KoljaWindeler/CHIP_QUESO/schematics/v4_adapter_ordered/single.png

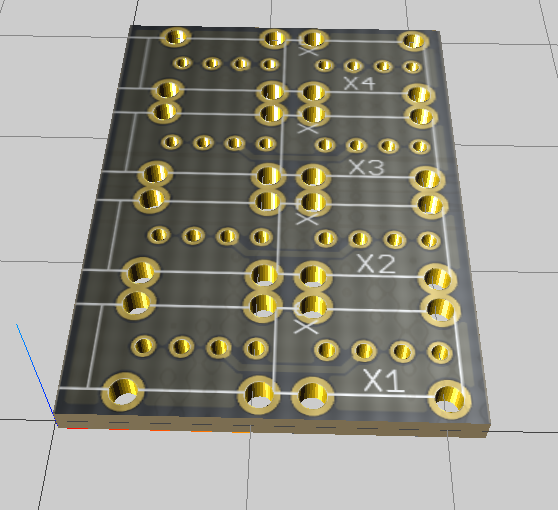
schematics/v4_adapter_ordered/single.png
