KoljaWindeler/CHIP_QUESO/docs/DSC_0504.JPG

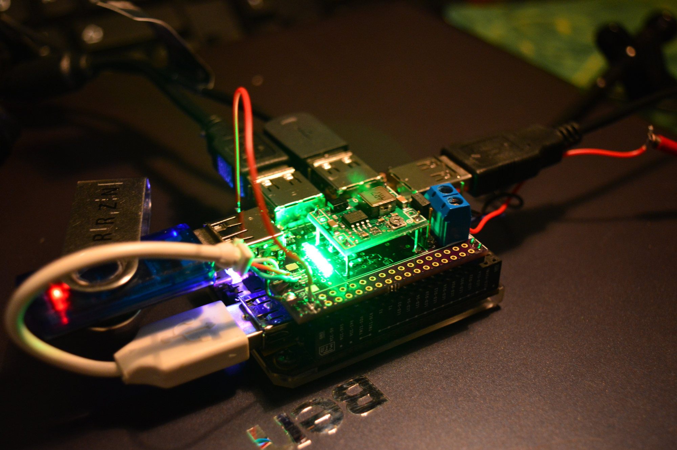
docs/DSC_0504.JPG
