KoljaWindeler/CHIP_QUESO/README

please read http://koljawindeler.github.io/CHIP_QUESO
