KoljaWindeler/CHIP_QUESO/docs/Dip_250x338.bmp

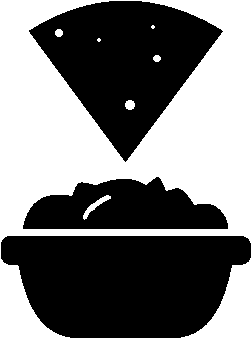
docs/Dip_250x338.bmp
