KoljaWindeler/CHIP_QUESO/docs/DSC_0506.JPG

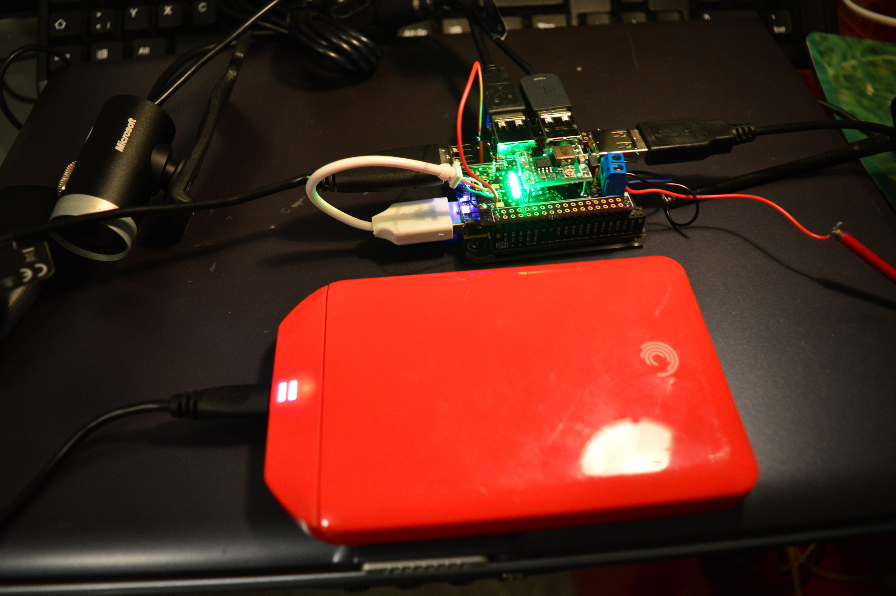
docs/DSC_0506.JPG
