KoljaWindeler/CHIP_QUESO/schematics/v45_ordered/queso_dip_v4_5.pdf

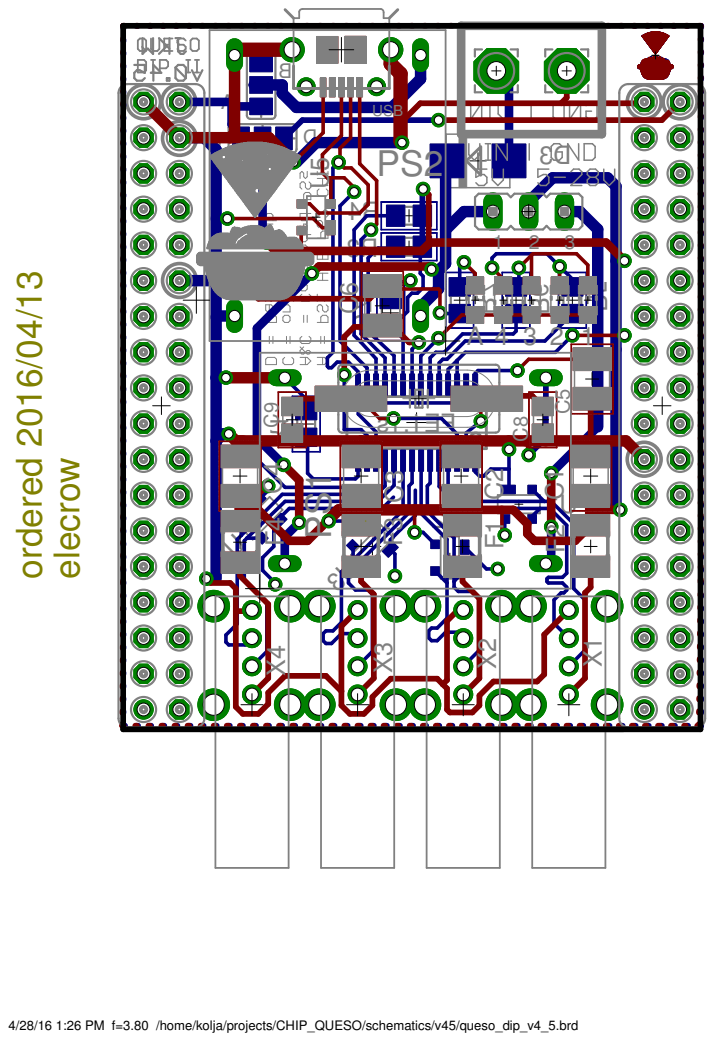
[picture p6: page 1]

4/28/16 1:26 PM f=3.80 /home/kolja/projects/CHIP_QUESO/schematics/v45/queso_dip_v4_5.brd
