KoljaWindeler/CHIP_QUESO/schematics/v45_ordered/queso_dip_v4_5_sch.pdf

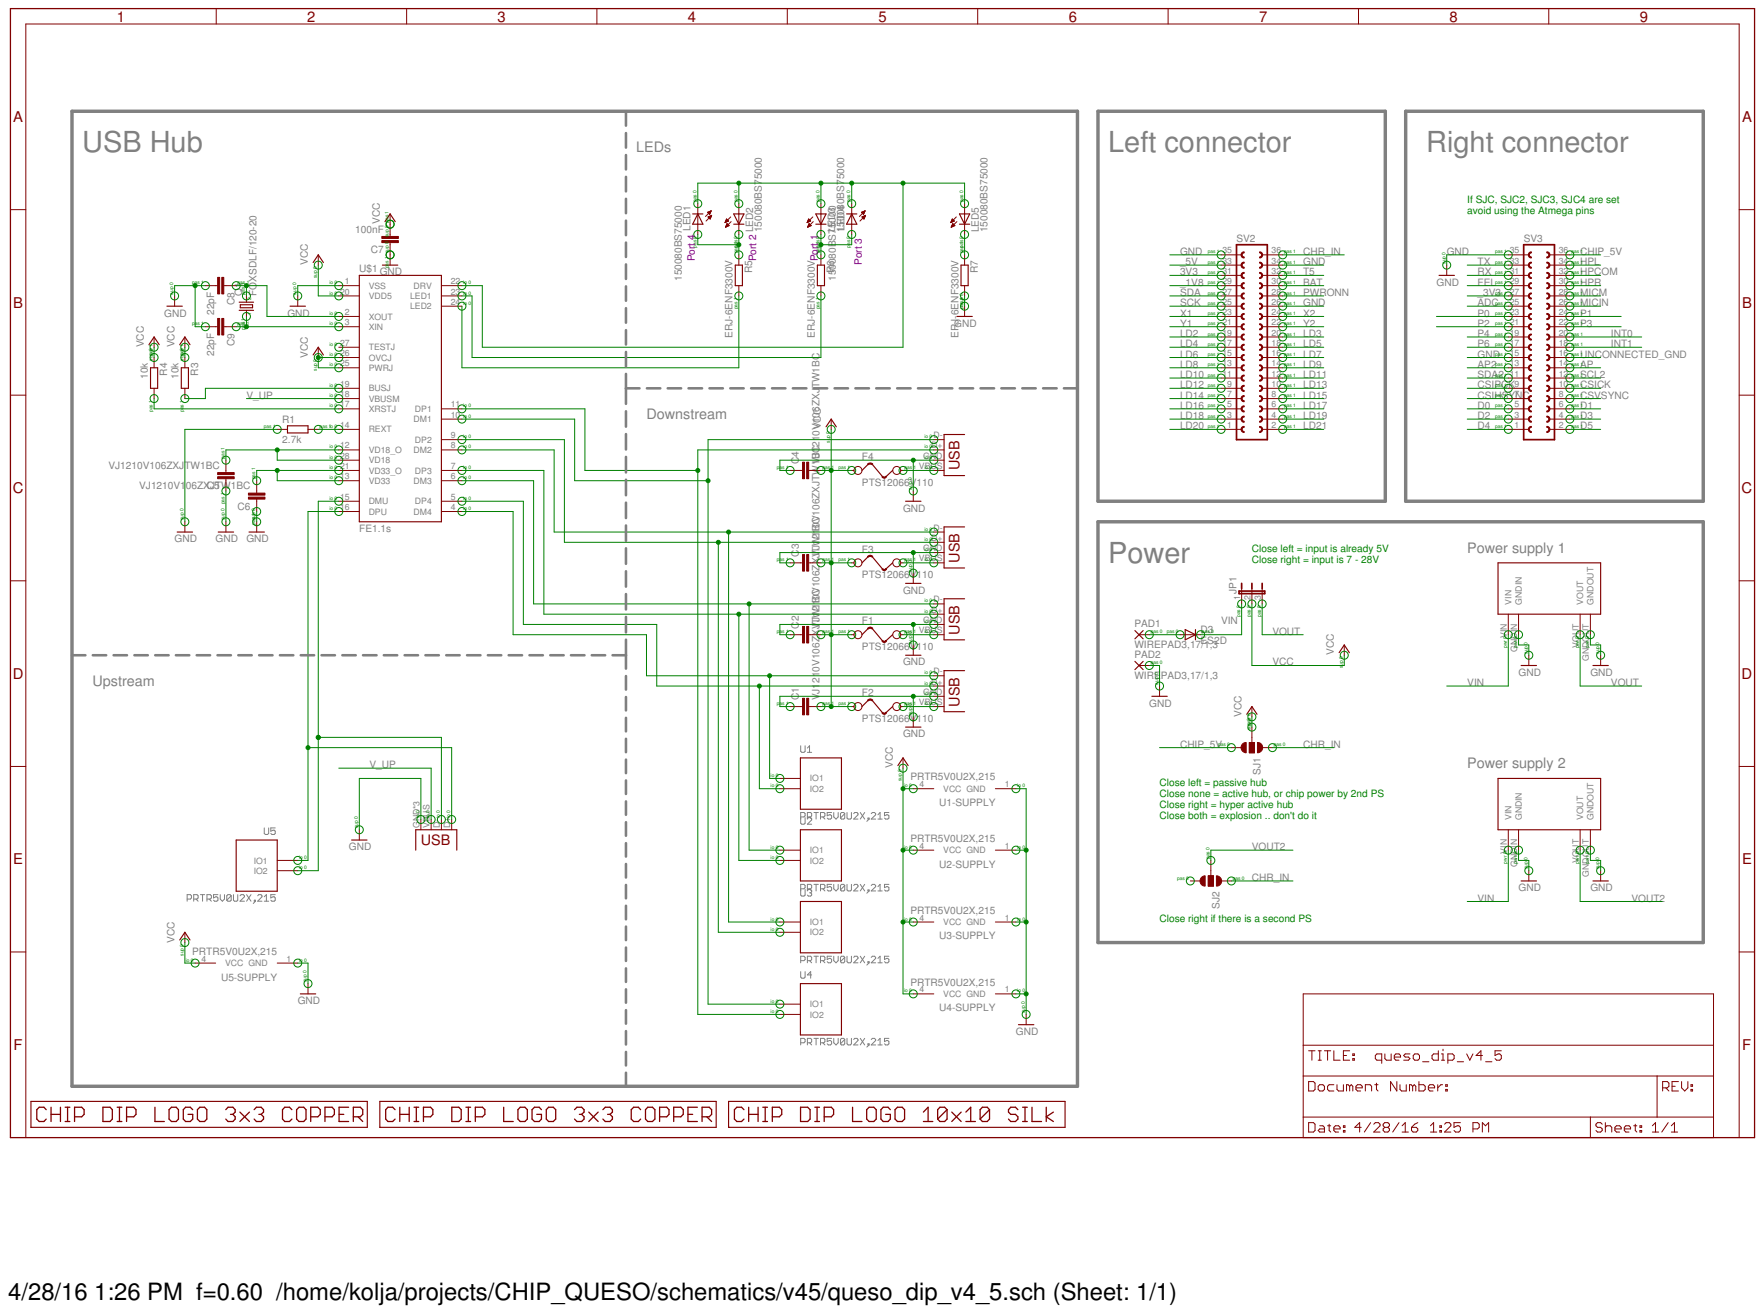
[picture p7: page 1]

If SJC, SJC2, SJC3, SJC4 are set avoid using the Atmega pins

pas 1 pas 1 sup 0 sup 0

USB USB

sup 0 sup 0
GND

Close left = input is already 5V Close right = input is 7 - 28V

pas 1 | pas 1 | pas 1 pas 1 PTS12066V110 | VBUS io 0

VOUT VOUT GNDOUT GNDOUT

D- D+ GND io 0

pas 1 | pas 1 | pas 1 | VBUS io 0

Close left = passive hub Close none = active hub, or chip power by 2nd PS Close right = hyper active hub Close both = explosion .. don't do it

Close right if there is a second PS

4/28/16 1:26 PM f=0.60 /home/kolja/projects/CHIP_QUESO/schematics/v45/queso_dip_v4_5.sch (Sheet: 1/1)
