KoljaWindeler/CHIP_QUESO/schematics/v101/queso_dip_v101.brd

## EAGLE design schematics/v101/queso_dip_v101.brd (2016-12-20)

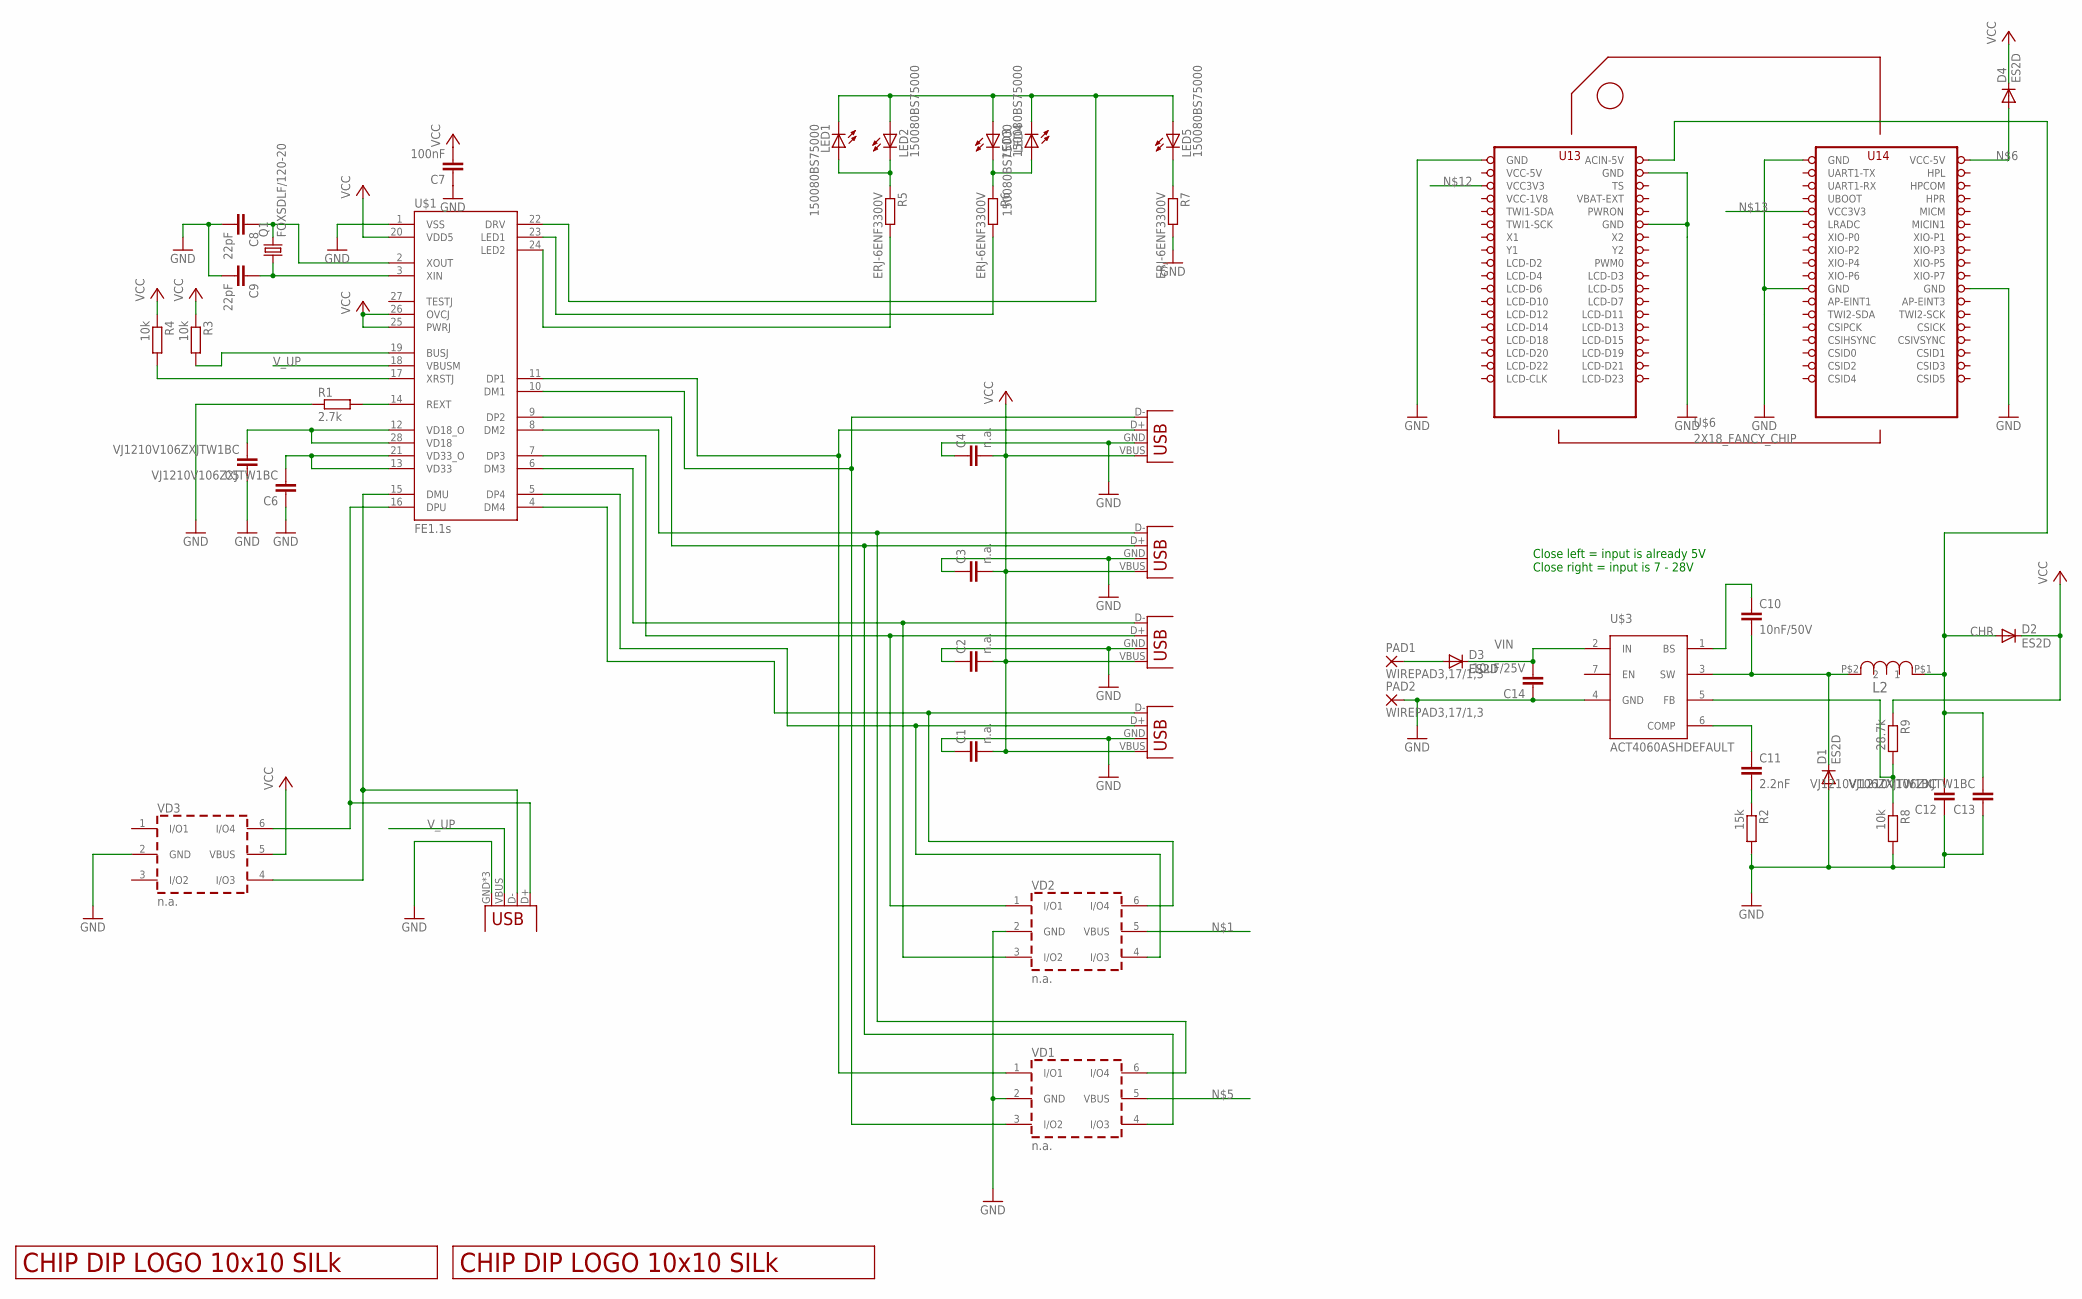
[picture p8: schematic queso_dip_v101.sch]

Parts:
C1, C2, C3, C4: n.a.; C1210
C5, C6, C12, C13: VJ1210V106ZXJTW1BC; C1210
C7: 100nF; C0805
C8, C9: 22pF; C0805
C10: 10nF/50V; C0805
C11: 2.2nF; C0805
C14: 10uF/25V; C1210
D1, D2, D3, D4: ES2D; SMB
DATA_USB: USBUSB-MICROB-SMT-DIP; USB-MICROB-SMT-DIP
L2: SRN6045-100M; SRN6045
LED1, LED2, LED3, LED4, LED5: 150080BS75000; CHIP-LED0805
PAD1, PAD2: WIREPAD3,17/1,3; 3,17/1,3
Q1: FOXSDLF/120-20; SM49
R1: 2.7k; R0805
R2: 15k; R0805
R3, R4, R8: 10k; R0805
R5, R6, R7: ERJ-6ENF3300V; R0805
R9: 28.7k; R0805
U$1: FE1.1S; FE1.1S_SSOP-28
U$2, U$4: LOGO_10X10_SILK; LOGO2_10X10_SILK
U$3: ACT4060ASHDEFAULT; SOP-8
U$6: 2X18_FANCY_CHIP; 2X18_FANCY_EDGE_CHIP_TH
VD1, VD2, VD3: n.a.; SOT-23-6L
X1, X2, X3, X4: USB-A-HU

Connections:
CHR: C12.2, C13.2, D2.A, L2.P$1 (1), U$6.36 (ACIN-5V)
DM1: U$1.10 (DM1), VD1.3 (I/O2), X4.D- (D+)
DM2: U$1.8 (DM2), VD1.6 (I/O4), X3.D- (D+)
DM3: U$1.6 (DM3), VD2.3 (I/O2), X2.D- (D+)
DM4: U$1.4 (DM4), VD2.6 (I/O4), X1.D- (D+)
DMU: DATA_USB.D-, U$1.15 (DMU), VD3.4 (I/O3)
DP1: U$1.11 (DP1), VD1.1 (I/O1), X4.D+ (D-)
DP2: U$1.9 (DP2), VD1.4 (I/O3), X3.D+ (D-)
DP3: U$1.7 (DP3), VD2.1 (I/O1), X2.D+ (D-)
DP4: U$1.5 (DP4), VD2.4 (I/O3), X1.D+ (D-)
DPU: DATA_USB.D+, U$1.16 (DPU), VD3.6 (I/O4)
GND: C1.1, C2.1, C3.1, C4.1, C5.1, C6.1, C7.1, C8.2, C9.2, C12.1, C13.1, C14.1, D1.A, DATA_USB.GND, DATA_USB.MT1 (GND), DATA_USB.MT2 (GND), PAD2.1, R1.1, R7.2, R8.2, U$1.1 (VSS), U$3.4 (GND), U$6.26 (GND), U$6.34 (GND), U$6.35 (GND), U$6.51 (GND), U$6.52 (GND), U$6.71 (GND), VD1.2 (GND), VD2.2 (GND), VD3.2 (GND), X1.GND (VBUS), X2.GND (VBUS), X3.GND (VBUS), X4.GND (VBUS)
unnamed: D3.A, PAD1.1
unnamed: D4.A, U$6.72 (VCC-5V)
unnamed: C10.2, D1.C, L2.P$2 (2), U$3.3 (SW)
unnamed: C10.1, U$3.1 (BS)
unnamed: C11.2, R2.1
unnamed: C11.1, U$3.6 (COMP)
unnamed: R8.1, R9.2, U$3.5 (FB)
unnamed: R5.2, U$1.24 (LED2)
unnamed: R6.2, U$1.23 (LED1)
unnamed: C6.2, U$1.13 (VD33), U$1.21 (VD33_O)
unnamed: C5.2, U$1.12 (VD18_O), U$1.28 (VD18)
unnamed: R1.2, U$1.14 (REXT)
unnamed: R4.2, U$1.17 (XRSTJ)
unnamed: R3.2, U$1.19 (BUSJ)
unnamed: C8.1, Q1.2, U$1.2 (XOUT)
unnamed: C9.1, Q1.1, U$1.3 (XIN)
unnamed: LED5.C, R7.1
unnamed: LED3.C, LED4.A, R6.1
unnamed: LED1.A, LED2.C, R5.1
unnamed: LED1.C, LED2.A, LED3.A, LED4.C, LED5.A, U$1.22 (DRV)
VCC: C1.2, C2.2, C3.2, C4.2, C7.2, D2.C, D4.C, R3.1, R4.1, R9.1, U$1.20 (VDD5), U$1.25 (PWRJ), U$1.26 (OVCJ), VD3.5 (VBUS), X1.VBUS (GND), X2.VBUS (GND), X3.VBUS (GND), X4.VBUS (GND)
VCC-1V8: U$6.29 (VCC-1V8)
VCC-5V: U$6.33 (VCC-5V)
VIN: C14.2, D3.C, U$3.2 (IN)
V_UP: DATA_USB.VBUS, U$1.18 (VBUSM)

Notes on the sheet:
Close left = input is already 5V Close right = input is 7 - 28V

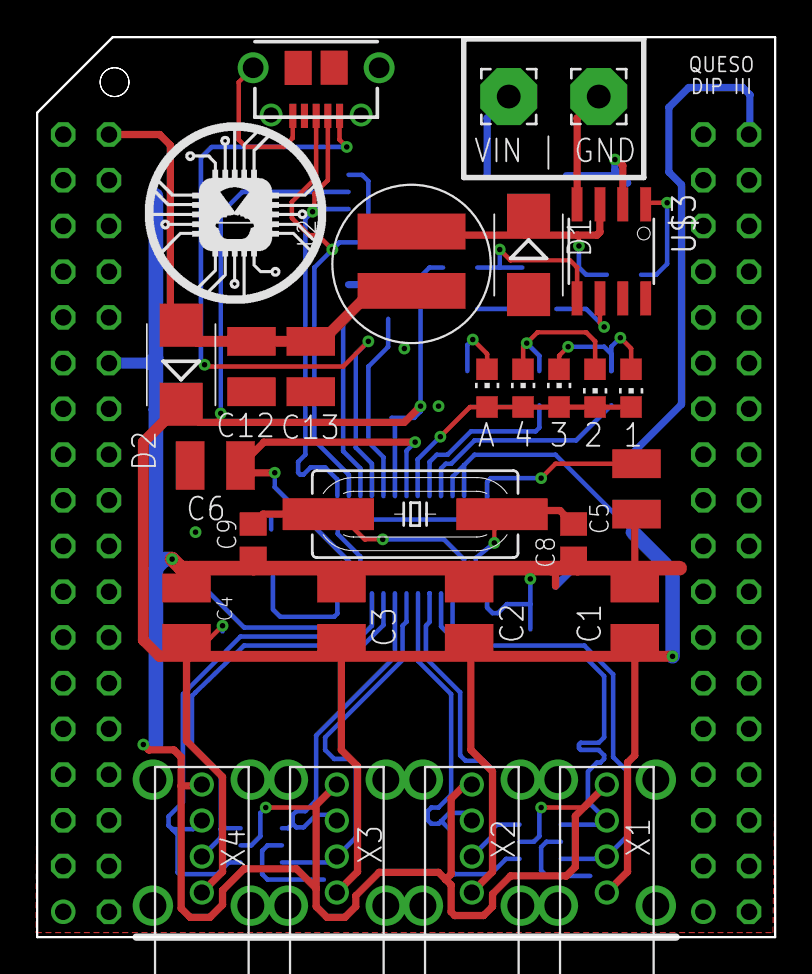
[picture p9: board queso_dip_v101.brd from above]

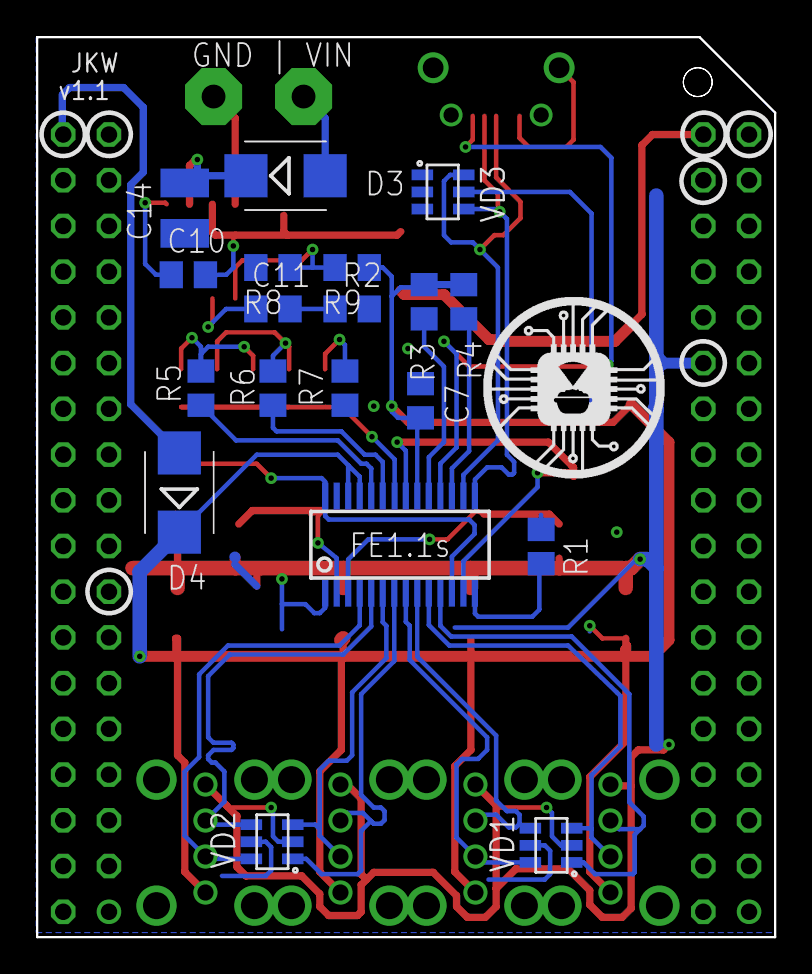
[picture p10: board queso_dip_v101.brd from below]

Board: 2 copper layers, 41.0 x 50.0 mm, 49 parts (20 on the bottom side), 35 nets.
