KoljaWindeler/CHIP_QUESO/schematics/v46_ordered/queso_dip_v4_6.brd

## EAGLE design schematics/v46_ordered/queso_dip_v4_6.brd (2016-05-03, an earlier design)

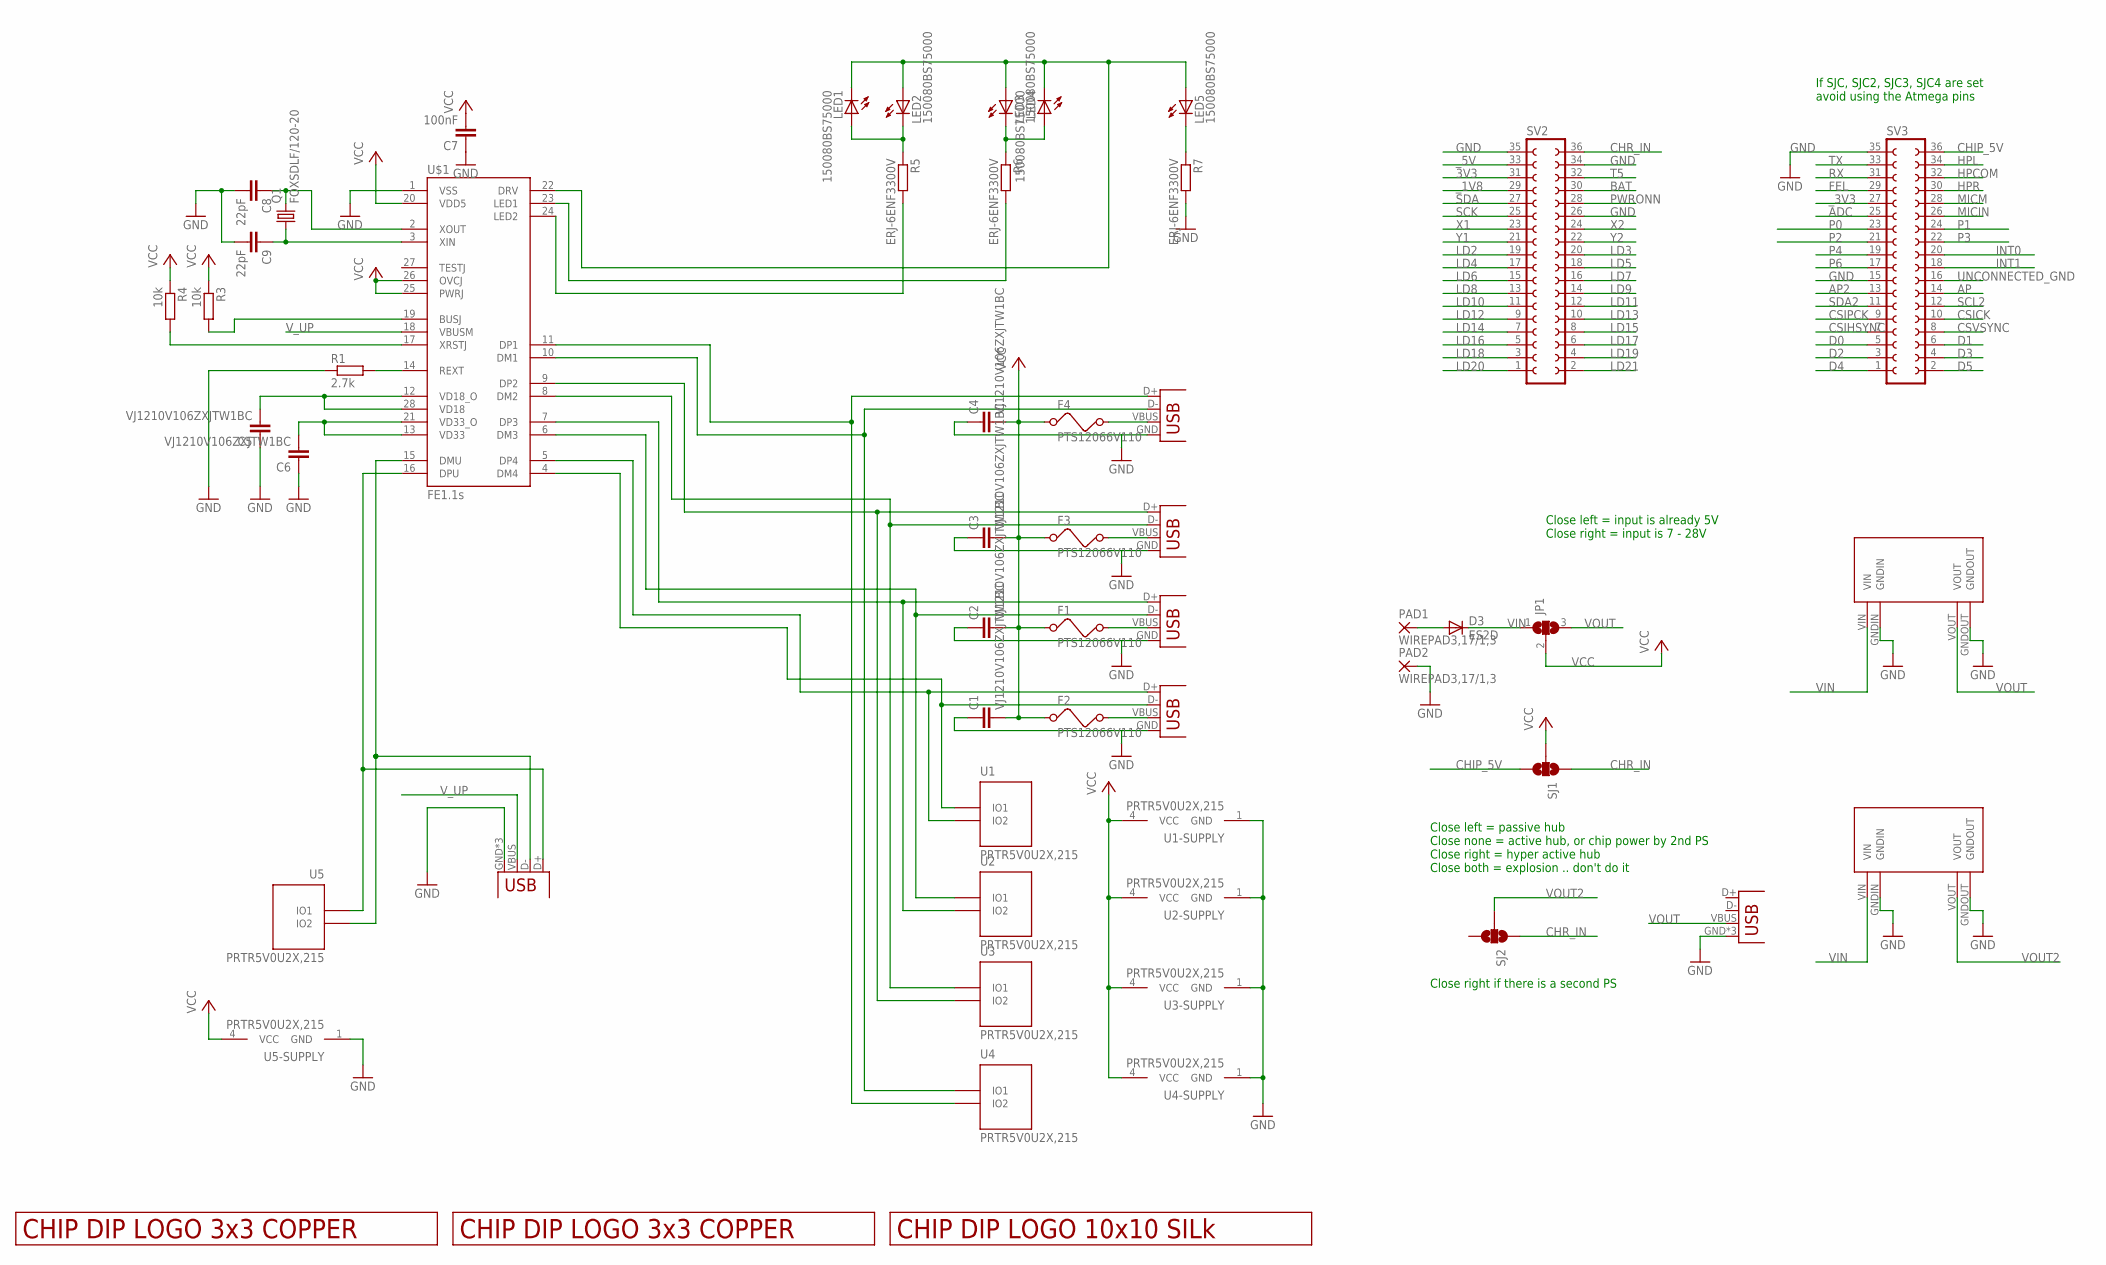
[picture p11: schematic queso_dip_v4_6.sch]

Parts:
C1, C2, C3, C4, C5, C6: VJ1210V106ZXJTW1BC; C1210
C7: 100nF; C0805
C8, C9: 22pF; C0805
D3: ES2D; SMB
F1, F2, F3, F4: PTS12066V110; 1210
JP1: SJ2W; SJ_2
LED1, LED2, LED3, LED4, LED5: 150080BS75000; CHIP-LED0805
PAD1, PAD2: WIREPAD3,17/1,3; 3,17/1,3
Q1: FOXSDLF/120-20; SM49
R1: 2.7k; R0805
R3, R4: 10k; R0805
R5, R6, R7: ERJ-6ENF3300V; R0805
SJ1, SJ2: SOLDERJUMPER_2WAYT; SJ_2
SV2, SV3: FE18-2
U1, U2, U3, U4, U5: PRTR5V0U2X,215; SOT-143B
U$1: FE1.1S; FE1.1S_SSOP-28
U$2, U$4: LOGO_3X3_COPPER
U$3, U$9: MP1584EN
U$5: LOGO_10X10_SILK
USB, USB1: USBUSB-MICROB-SMT-DIP; USB-MICROB-SMT-DIP
X1, X2, X3, X4: USB-A-S

Connections:
3V3: SV2.31
ADC: SV3.25
AP: SV3.14
AP2: SV3.13
BAT: SV2.30
CHIP_5V: SJ1.3, SV3.36
CHR_IN: SJ1.1, SJ2.1, SV2.36
CSICK: SV3.10
CSIHSYNC: SV3.7
CSIPCK: SV3.9
CSVSYNC: SV3.8
D0: SV3.5
D1: SV3.6
D2: SV3.3
D3: SV3.4
D4: SV3.1
D5: SV3.2
DM1: U4.2 (IO1), U$1.10 (DM1), X4.D-
DM2: U3.2 (IO1), U$1.8 (DM2), X3.D-
DM3: U2.2 (IO1), U$1.6 (DM3), X2.D-
DM4: U1.2 (IO1), U$1.4 (DM4), X1.D-
DMU: U5.3 (IO2), U$1.15 (DMU), USB.D-
DP1: U4.3 (IO2), U$1.11 (DP1), X4.D+
DP2: U3.3 (IO2), U$1.9 (DP2), X3.D+
DP3: U2.3 (IO2), U$1.7 (DP3), X2.D+
DP4: U1.3 (IO2), U$1.5 (DP4), X1.D+
DPU: U5.2 (IO1), U$1.16 (DPU), USB.D+
FEL: SV3.29
GND: C1.1, C2.1, C3.1, C4.1, C5.1, C6.1, C7.1, C8.2, C9.2, PAD2.1, R1.1, R7.2, SV2.26, SV2.34, SV2.35, SV3.15, SV3.35, U1.1 (GND), U2.1 (GND), U3.1 (GND), U4.1 (GND), U5.1 (GND), U$1.1 (VSS), U$3.GNDIN, U$3.GNDOUT, U$9.GNDIN, U$9.GNDOUT, USB.GND, USB.MT1 (GND), USB.MT2 (GND), USB1.GND, USB1.MT1 (GND), USB1.MT2 (GND), X1.GND, X2.GND, X3.GND, X4.GND
HPCOM: SV3.32
HPL: SV3.34
HPR: SV3.30
INT0: SV3.20
INT1: SV3.18
LD2: SV2.19
LD3: SV2.20
LD4: SV2.17
LD5: SV2.18
LD6: SV2.15
LD7: SV2.16
LD8: SV2.13
LD9: SV2.14
LD10: SV2.11
LD11: SV2.12
LD12: SV2.9
LD13: SV2.10
LD14: SV2.7
LD15: SV2.8
LD16: SV2.5
LD17: SV2.6
LD18: SV2.3
LD19: SV2.4
LD20: SV2.1
LD21: SV2.2
MICIN: SV3.26
MICM: SV3.28
unnamed: F2.2, X1.VBUS
unnamed: D3.A, PAD1.1
unnamed: F4.2, X4.VBUS
unnamed: F1.2, X2.VBUS
unnamed: F3.2, X3.VBUS
unnamed: R5.2, U$1.24 (LED2)
unnamed: R6.2, U$1.23 (LED1)
unnamed: C6.2, U$1.13 (VD33), U$1.21 (VD33_O)
unnamed: C5.2, U$1.12 (VD18_O), U$1.28 (VD18)
unnamed: R1.2, U$1.14 (REXT)
unnamed: R4.2, U$1.17 (XRSTJ)
unnamed: R3.2, U$1.19 (BUSJ)
unnamed: C8.1, Q1.2, U$1.2 (XOUT)
unnamed: C9.1, Q1.1, U$1.3 (XIN)
unnamed: LED5.C, R7.1
unnamed: LED3.C, LED4.A, R6.1
unnamed: LED1.A, LED2.C, R5.1
unnamed: LED1.C, LED2.A, LED3.A, LED4.C, LED5.A, U$1.22 (DRV)
P0: SV3.23
P1: SV3.24
P2: SV3.21
P3: SV3.22
P4: SV3.19
P6: SV3.17
PWRONN: SV2.28
RX: SV3.31
SCK: SV2.25
SCL2: SV3.12
SDA: SV2.27
SDA2: SV3.11
T5: SV2.32
TX: SV3.33
UNCONNECTED_GND: SV3.16
VCC: C1.2, C2.2, C3.2, C4.2, C7.2, F1.1, F2.1, F3.1, F4.1, JP1.2, R3.1, R4.1, SJ1.2, U1.4 (VCC), U2.4 (VCC), U3.4 (VCC), U4.4 (VCC), U5.4 (VCC), U$1.20 (VDD5), U$1.25 (PWRJ), U$1.26 (OVCJ)
VIN: D3.C, JP1.1, U$3.VIN, U$9.VIN
VOUT: JP1.3, U$9.VOUT, USB1.VBUS
VOUT2: SJ2.2, U$3.VOUT
V_UP: U$1.18 (VBUSM), USB.VBUS
X1: SV2.23
X2: SV2.24
Y1: SV2.21
Y2: SV2.22
_1V8: SV2.29
_3V3: SV3.27
_5V: SV2.33

Notes on the sheet:
If SJC, SJC2, SJC3, SJC4 are set avoid using the Atmega pins
Close left = passive hub Close none = active hub, or chip power by 2nd PS Close right = hyper active hub Close both = explosion .. don't do it
Close left = input is already 5V Close right = input is 7 - 28V
Close right if there is a second PS

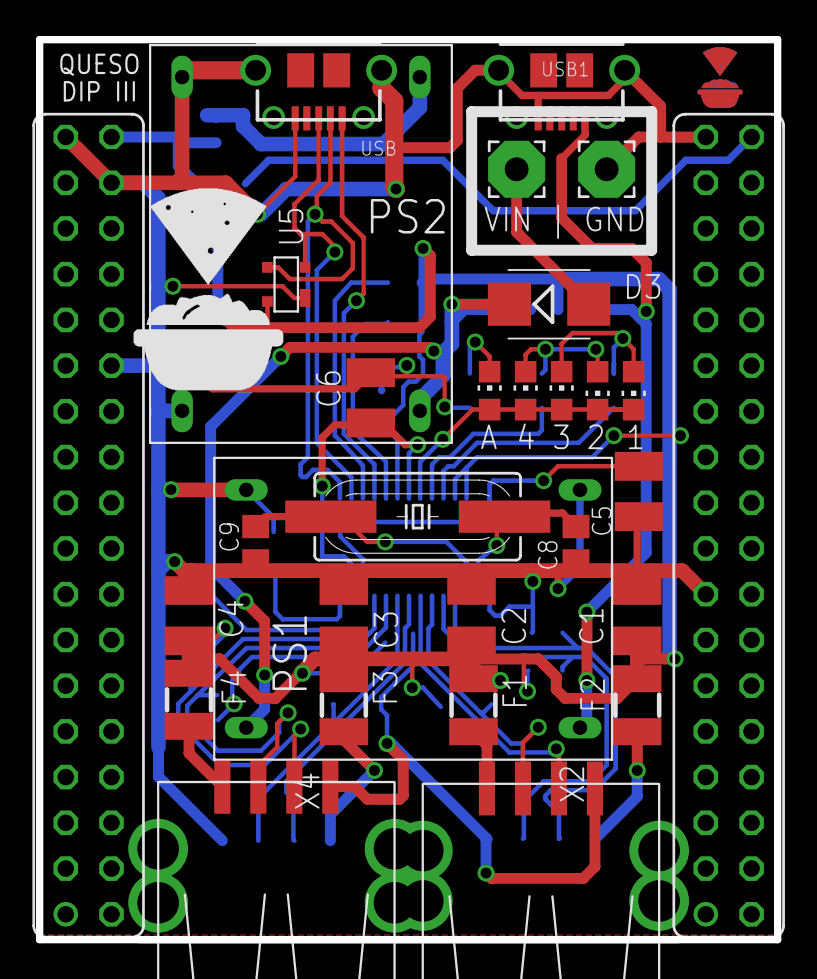
[picture p12: board queso_dip_v4_6.brd from above]

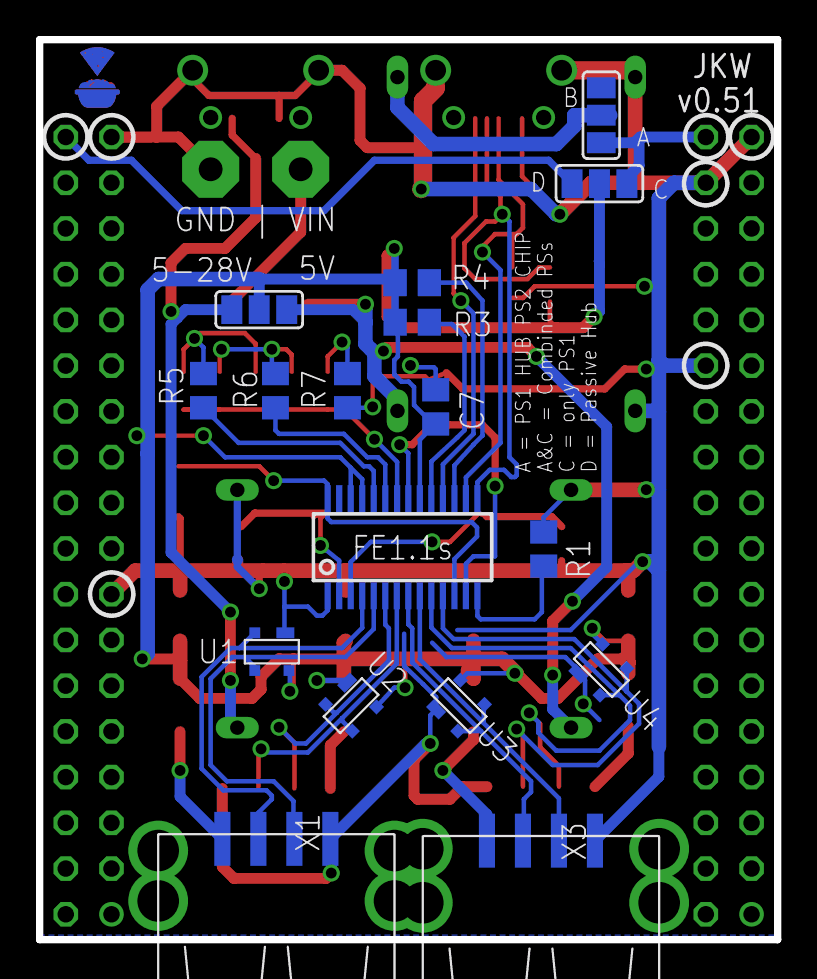
[picture p13: board queso_dip_v4_6.brd from below]

Board: 2 copper layers, 41.0 x 50.0 mm, 50 parts (18 on the bottom side), 36 nets.
