KoljaWindeler/CHIP_QUESO/schematics/v4_adapter_ordered/adapter.brd

## EAGLE design schematics/v4_adapter_ordered/adapter.brd (2016-04-28)

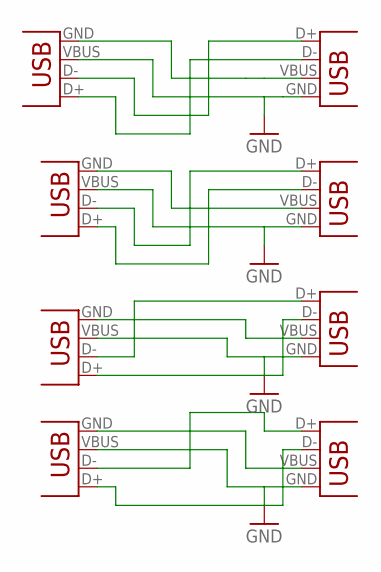
[picture p14: schematic adapter.sch]

Parts:
X1, X2, X3, X4, X5, X6, X7, X8: USB-A-HU

Connections:
DM1: X4.D-, X5.D+
DP1: X4.D+, X5.D-
GND: X1.GND, X2.GND, X3.GND, X4.GND, X5.VBUS, X6.VBUS, X7.VBUS, X8.VBUS
unnamed: X1.VBUS, X8.GND
unnamed: X3.D+, X6.D-
unnamed: X3.D-, X6.D+
unnamed: X2.D+, X7.D-
unnamed: X2.D-, X7.D+
unnamed: X1.D+, X8.D-
unnamed: X2.VBUS, X7.GND
unnamed: X3.VBUS, X6.GND
unnamed: X4.VBUS, X5.GND
unnamed: X1.D-, X8.D+

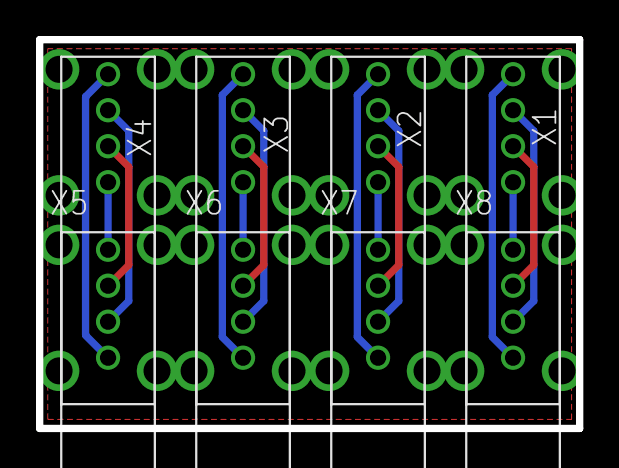
[picture p15: board adapter.brd from above]

Board: 2 copper layers, 30.0 x 21.6 mm, 8 parts (0 on the bottom side), 13 nets.
