KoljaWindeler/CHIP_QUESO/schematics/v4_adapter_ordered/adapter_3x2.brd

## EAGLE design schematics/v4_adapter_ordered/adapter_3x2.brd (2016-04-28)

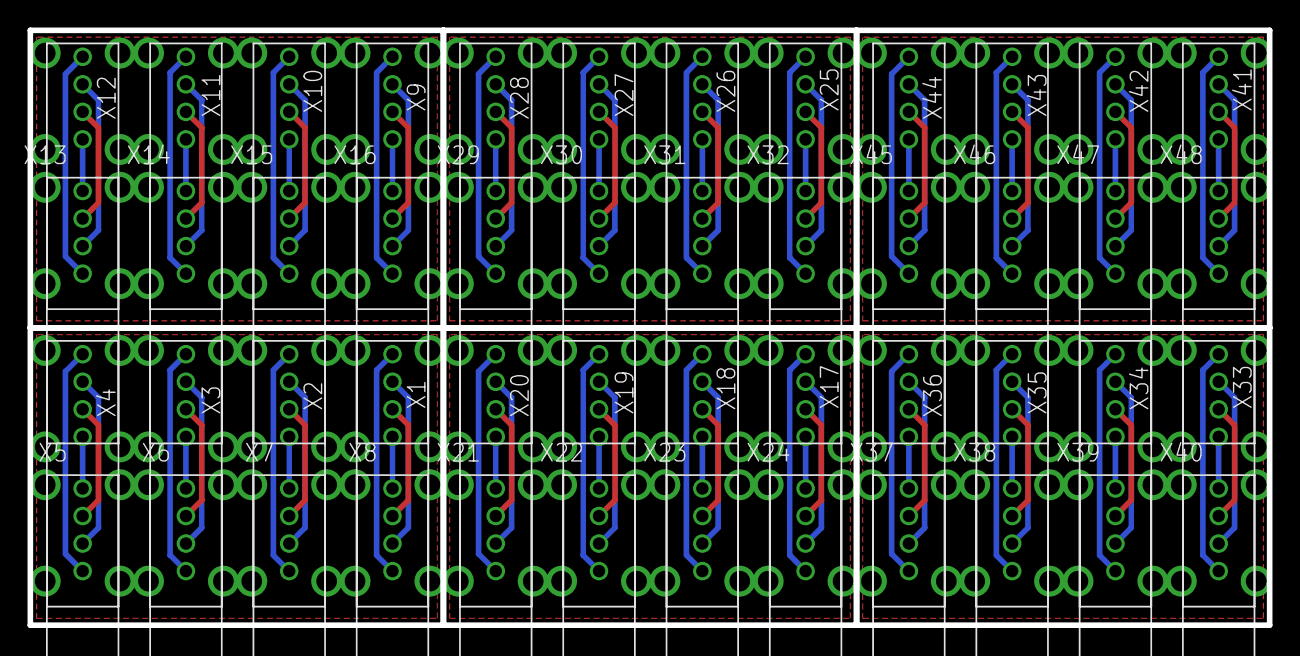
[picture p16: board adapter_3x2.brd from above]

Board: 2 copper layers, 90.0 x 43.2 mm, 48 parts (0 on the bottom side), 78 nets.

Parts:
X1, X2, X3, X4, X5, X6, X7, X8, X9, X10, X11, X12, X13, X14, X15, X16, X17, X18, X19, X20, X21, X22, X23, X24, X25, X26, X27, X28, X29, X30, X31, X32, X33, X34, X35, X36, X37, X38, X39, X40, X41, X42, X43, X44, X45, X46, X47, X48: USB-A-HU

Connections:
DM1: X4.D-, X5.D+
DM2: X12.D-, X13.D+
DM3: X20.D-, X21.D+
DM4: X28.D-, X29.D+
DM5: X36.D-, X37.D+
DM6: X44.D-, X45.D+
DP1: X4.D+, X5.D-
DP2: X12.D+, X13.D-
DP3: X20.D+, X21.D-
DP4: X28.D+, X29.D-
DP5: X36.D+, X37.D-
DP6: X44.D+, X45.D-
GND: X1.GND, X2.GND, X3.GND, X4.GND, X5.VBUS, X6.VBUS, X7.VBUS, X8.VBUS
GND1: X9.GND, X10.GND, X11.GND, X12.GND, X13.VBUS, X14.VBUS, X15.VBUS, X16.VBUS
GND2: X17.GND, X18.GND, X19.GND, X20.GND, X21.VBUS, X22.VBUS, X23.VBUS, X24.VBUS
GND3: X25.GND, X26.GND, X27.GND, X28.GND, X29.VBUS, X30.VBUS, X31.VBUS, X32.VBUS
GND4: X33.GND, X34.GND, X35.GND, X36.GND, X37.VBUS, X38.VBUS, X39.VBUS, X40.VBUS
GND5: X41.GND, X42.GND, X43.GND, X44.GND, X45.VBUS, X46.VBUS, X47.VBUS, X48.VBUS
unnamed: X1.VBUS, X8.GND
unnamed: X10.VBUS, X15.GND
unnamed: X3.D+, X6.D-
unnamed: X3.D-, X6.D+
unnamed: X11.VBUS, X14.GND
unnamed: X2.D+, X7.D-
unnamed: X2.D-, X7.D+
unnamed: X12.VBUS, X13.GND
unnamed: X1.D+, X8.D-
unnamed: X2.VBUS, X7.GND
unnamed: X3.VBUS, X6.GND
unnamed: X4.VBUS, X5.GND
unnamed: X1.D-, X8.D+
unnamed: X9.VBUS, X16.GND
unnamed: X11.D+, X14.D-
unnamed: X11.D-, X14.D+
unnamed: X10.D+, X15.D-
unnamed: X10.D-, X15.D+
unnamed: X9.D+, X16.D-
unnamed: X9.D-, X16.D+
unnamed: X18.VBUS, X23.GND
unnamed: X19.VBUS, X22.GND
unnamed: X20.VBUS, X21.GND
unnamed: X17.VBUS, X24.GND
unnamed: X19.D+, X22.D-
unnamed: X19.D-, X22.D+
unnamed: X18.D+, X23.D-
unnamed: X18.D-, X23.D+
unnamed: X17.D+, X24.D-
unnamed: X17.D-, X24.D+
unnamed: X26.VBUS, X31.GND
unnamed: X27.VBUS, X30.GND
unnamed: X28.VBUS, X29.GND
unnamed: X25.VBUS, X32.GND
unnamed: X27.D+, X30.D-
unnamed: X27.D-, X30.D+
unnamed: X26.D+, X31.D-
unnamed: X26.D-, X31.D+
unnamed: X25.D+, X32.D-
unnamed: X25.D-, X32.D+
unnamed: X34.VBUS, X39.GND
unnamed: X35.VBUS, X38.GND
unnamed: X36.VBUS, X37.GND
unnamed: X33.VBUS, X40.GND
unnamed: X35.D+, X38.D-
unnamed: X35.D-, X38.D+
unnamed: X34.D+, X39.D-
unnamed: X34.D-, X39.D+
unnamed: X33.D+, X40.D-
unnamed: X33.D-, X40.D+
unnamed: X42.VBUS, X47.GND
unnamed: X43.VBUS, X46.GND
unnamed: X44.VBUS, X45.GND
unnamed: X41.VBUS, X48.GND
unnamed: X43.D+, X46.D-
unnamed: X43.D-, X46.D+
unnamed: X42.D+, X47.D-
unnamed: X42.D-, X47.D+
unnamed: X41.D+, X48.D-
unnamed: X41.D-, X48.D+
