KoljaWindeler/CHIP_QUESO/schematics/v1/usb_dip_v1.brd

## EAGLE design schematics/v1/usb_dip_v1.brd (2016-03-15, an earlier design)

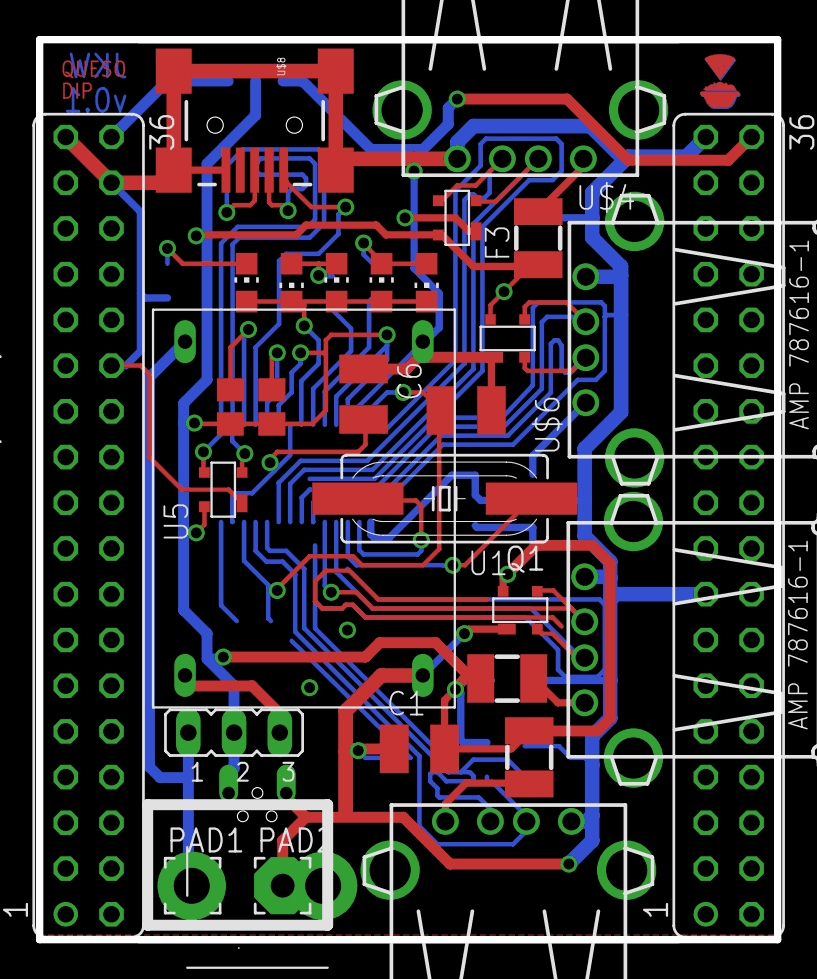
[picture p17: board usb_dip_v1.brd from above]

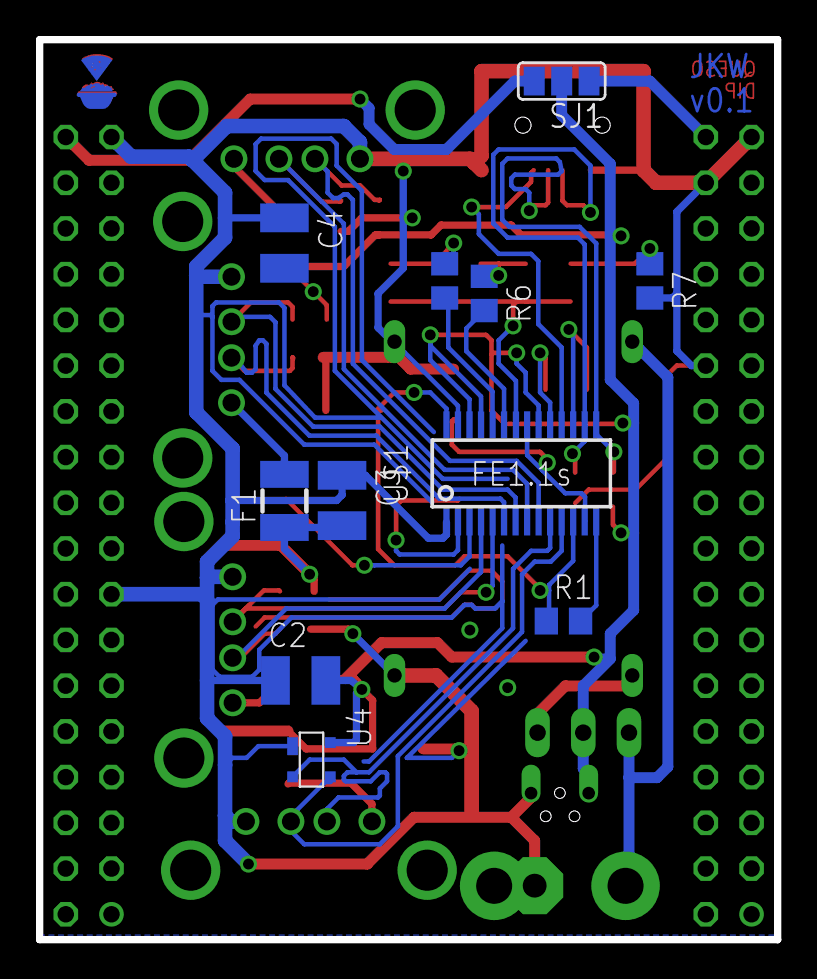
[picture p18: board usb_dip_v1.brd from below]

Board: 2 copper layers, 41.0 x 50.0 mm, 43 parts (12 on the bottom side), 34 nets.

Parts:
C1, C2, C3, C4, C5, C6: 10uF; C1210
F1, F2, F3, F4: 1210
JP1: JP2
LED1, LED2, LED3, LED4, LED5: CHIP-LED0805
PAD1, PAD2: WIREPAD3,17/1,3; 3,17/1,3
Q1: SM49
R1: 2.7k; R0805
R3, R4: 10k; R0805
R5, R6, R7: 330R; R0805
SJ1: SJ_2
SV2, SV3: FE18-2
U1, U2, U3, U4, U5: PRTR5V0U2X; SOT-143B
U$1: FE1.1S; FE1.1S_SSOP-28
U$2, U$5: LOGO
U$3, U$4, U$6, U$7: USB_TYPE_A_FEMALE_TH
U$8: USB-MINIB-5PIN; USB-MINIB
U$9: MP1584EN
U$10: USB-PWR; USB-MINIB-THM-MOLEX-PWRONLY

Connections:
CHIP_5V: SJ1.3, SV3.36
CHR_IN: SJ1.1, SV2.36
DM1: U4.2, U$1.10, U$3.2
DM2: U3.2, U$1.8, U$4.2
DM3: U2.2, U$1.6, U$6.2
DM4: U1.2, U$1.4, U$7.2
DMU: U5.3, U$1.15, U$8.D-
DP1: U4.3, U$1.11, U$3.3
DP2: U3.3, U$1.9, U$4.3
DP3: U2.3, U$1.7, U$6.3
DP4: U1.3, U$1.5, U$7.3
DPU: U5.2, U$1.16, U$8.D+
GND: C1.1, C2.1, C3.1, C4.1, C5.1, C6.1, PAD2.1, R7.2, SV2.26, SV2.34, SV2.35, SV3.15, SV3.35, U1.1, U2.1, U3.1, U4.1, U5.1, U$1.1, U$1.27, U$3.4, U$4.4, U$6.4, U$7.4, U$8.GND, U$8.MTN1, U$8.MTN2, U$8.MTN3, U$8.MTN4, U$9.GNDIN, U$9.GNDOUT, U$10.GND
unnamed: F2.2, U$7.1
unnamed: F1.2, U$6.1
unnamed: F3.2, U$4.1
unnamed: F4.2, U$3.1
unnamed: R5.2, U$1.24
unnamed: R6.2, U$1.23
unnamed: C6.2, U$1.13, U$1.21
unnamed: C5.2, R1.1, U$1.12, U$1.28
unnamed: R1.2, U$1.14
unnamed: R4.2, U$1.17
unnamed: R3.2, U$1.19
unnamed: Q1.2, U$1.2
unnamed: Q1.1, U$1.3
unnamed: LED5.C, R7.1
unnamed: LED3.C, LED4.A, R6.1
unnamed: LED1.A, LED2.C, R5.1
unnamed: LED1.C, LED2.A, LED3.A, LED4.C, LED5.A, U$1.22
VCC: C1.2, C2.2, C3.2, C4.2, F1.1, F2.1, F3.1, F4.1, JP1.2, R3.1, R4.1, SJ1.2, U1.4, U2.4, U3.4, U4.4, U5.4, U$1.20, U$1.25, U$1.26, U$10.VBUS
VIN: JP1.1, PAD1.1, U$9.VIN
VOUT: JP1.3, U$9.VOUT
V_UP: U$1.18, U$8.VBUS
