KoljaWindeler/CHIP_QUESO/(commit log)

2016-03-01 move schematics to subdir and added doc
    [usb_dip_v1.brd, usb_dip_v1.sch]
2016-03-02 osh order
    [usb_dip_v1.brd, usb_dip_v1.sch]
2016-03-02 Ordered Board v1 at OSH and seeed, renamed dev version
    [usb_dip_v1.GBL, usb_dip_v1.GBO, usb_dip_v1.GBP, usb_dip_v1.GBS, usb_dip_v1.GTL, usb_dip_v1.GTO, usb_dip_v1.GTP, usb_dip_v1.GTS]
2016-03-07 added new version
    [queso_dip_v2.brd, queso_dip_v2.csv, queso_dip_v2.sch, queso_dip_v3.brd, queso_dip_v3.sch, usb_dip_v1.csv]
2016-03-07 routing for version3
    [queso_dip_v3.brd, queso_dip_v3.sch]
2016-03-09 improved silkscreen
    [queso_dip_v3.brd]
2016-03-09 added gerber + bom
    [bom.csv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]
2016-03-10 cleaned schematic, rearranged leds (again)
    [queso_dip_v4.brd, queso_dip_v4.sch]
2016-03-12 v4, final version for vertical jacks
    [bom.csv]
2016-03-12 dual double jacks
    [queso_dip_v5.brd, queso_dip_v5.sch]
2016-03-12 added order notes to all boards
    [queso_dip_v2.brd, queso_dip_v3.brd, queso_dip_v4.brd, queso_dip_v5.brd]
2016-03-15 fixed micro usb
    [bom.csv, queso_dip_v4.brd, queso_dip_v4.sch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]
2016-03-15 removed temp
    [usb_dip_v1.brd]
2016-03-15 add spark lib with corrected USB footprint
2016-03-15 version with stacked USB
    [queso_dip_v5.brd, queso_dip_v5.sch]
2016-03-15 clean up
    [queso_dip_v5.brd, queso_dip_v5.sch]
2016-03-15 added silk logo
    [queso_dip_v4_2.brd, queso_dip_v4_2.sch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]
2016-03-16 new logo
    [queso_dip_v4_2.brd, queso_dip_v4_2.sch]
2016-03-17 ordered v4 with correct vss
    [bom.csv, queso_dip_v4.brd, queso_dip_v4.sch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]
2016-03-17 added photos, disconnect TESTPIN
    [queso_dip_v4_3.GBL, queso_dip_v4_3.GBO, queso_dip_v4_3.GBP, queso_dip_v4_3.GBS, queso_dip_v4_3.GTL, queso_dip_v4_3.GTO, queso_dip_v4_3.GTP, queso_dip_v4_3.GTS]
2016-03-27 updated v4.4
    [queso_dip_v4_4.brd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]
2016-04-03 added version 0.45, crystal load caps, polarity protection diode
    [queso_dip_v4_5.brd, queso_dip_v4_5.sch]
2016-04-03 fixed rotated label
    [queso_dip_v4_5.brd]
2016-04-11 adapter to save queso
    [adapter2.GBL, adapter2.GBO, adapter2.GBP, adapter2.GBS, adapter2.GTL, adapter2.GTO, adapter2.GTP, adapter2.GTS]
2016-04-28 sch + adapter
    [adapter.GBL, adapter.GBO, adapter.GBP, adapter.GBS, adapter.GTL, adapter.GTO, adapter.GTP, adapter.GTS]
2016-04-29 added usb powered version
    [queso_dip_v4_5.GBL, queso_dip_v4_5.GBO, queso_dip_v4_5.GBP, queso_dip_v4_5.GBS, queso_dip_v4_5.GTL, queso_dip_v4_5.GTO, queso_dip_v4_5.GTP, queso_dip_v4_5.GTS]
2016-05-03 added flat usb version
    [queso_dip_v4_5.brd, queso_dip_v4_5.sch]
2016-05-03 moved v45 to ordered
    [queso_dip_v4_5.GBL, queso_dip_v4_5.GBO, queso_dip_v4_5.GBP, queso_dip_v4_5.GBS, queso_dip_v4_5.GTL, queso_dip_v4_5.GTO, queso_dip_v4_5.GTP, queso_dip_v4_5.GTS]
2016-05-06 added labels for voltage check, moved version label, cut corner off
    [queso_dip_v4_5.GBL, queso_dip_v4_5.GBO, queso_dip_v4_5.GBP, queso_dip_v4_5.GBS, queso_dip_v4_5.GTL, queso_dip_v4_5.GTO, queso_dip_v4_5.GTP, queso_dip_v4_5.GTS]
2016-06-20 fixed DRC
    [queso_dip_v4_8.brd, queso_dip_v4_8.sch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]
2016-06-20 legacy adapter
    [adapter_single.brd]
2016-06-20 added edge
    [queso_dip_v4_8.brd]
2016-07-15 replaced ESD diode and added quote
    [PCBA with elecrow quotation_adapter V3.xlsx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]
2016-07-19 ordered v49
    [PCBA with elecrow quotation_adapter V3.xlsx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]
2016-07-19 added reduced cost version,
    [queso_dip_v100.brd, queso_dip_v100.sch, quotation_v100.xlsx]
2016-07-20 added assembly drawing
2016-07-20 moved quotations to dedicated folder
    [PCBA with elecrow quotation_adapter V3.xlsx, queso_dip_v2.csv, quotation_v100.xlsx]
2016-07-20 added assembly help
2016-07-20 added gerber files, modified vias to miniumum drill and added aliexpress link to quotation
    [queso_dip_v100.GBL, queso_dip_v100.GBO, queso_dip_v100.GBP, queso_dip_v100.GBS, queso_dip_v100.GTL, queso_dip_v100.GTO, queso_dip_v100.GTP, queso_dip_v100.GTS]
2016-08-29 moved gerber to subfolder
    [queso_dip_v49.GBL, queso_dip_v49.GBO, queso_dip_v49.GBP, queso_dip_v49.GBS, queso_dip_v49.GTL, queso_dip_v49.GTO, queso_dip_v49.GTP, queso_dip_v49.GTS]
2016-10-17 updated quatation, v49_ordered design
    [PCBA_with_elecrow_quotation_adapter_V5.xlsx]
2016-12-06 added onboard power supply
    [queso_dip_v101.brd, queso_dip_v101.sch]
2016-12-06 removed v100
    [queso_dip_v100.GBL, queso_dip_v100.GBO, queso_dip_v100.GBP, queso_dip_v100.GBS, queso_dip_v100.GTL, queso_dip_v100.GTO, queso_dip_v100.GTP, queso_dip_v100.GTS]
2016-12-20 added dual power
    [queso_dip_v101.brd, queso_dip_v101.sch]
