KoljaWindeler/CHIP_QUESO/(notices)

Notices in the files:
parts and their libraries:
m-pad-2.1: License : GNU General Public License version 2 (see bottom)
Volks73-NXPSemiconductors: Creative Commons Attribution-ShareAlike 3.0 Unported (CC BY-SA 3.0), http://creativecommons.org/licenses/by-sa/3.0/.
